vaTomas/PowerTrack/notes/hardware_dictionary.txt

ACS712			Current Sensor

PZEM-004T		Energy Monitor

ZMPT101B		Current and Voltage Transformer
ZMCT103C		Current and Voltage Transformer

SSR-10DA		Power Switch (Prefered)
SRD-05VDC-SL-C		Power Switch (not prefered because of noise)

CD405xB			Analog Multiplexer

HLK-PM12		Power Supply
