vaTomas/PowerTrack/notes/list_decoder_3_to_8.txt

3-to-8 Line Decoder List

Bcd to decimal
74x238	driver	active high
74x138		active low

line to line
74x145	driver
74x141	driver
74x45	driver
74x41	driver
74x42
