vaTomas/PowerTrack/notes/pin_maping.txt

Analog (6 Pins)
A0	LCD Display				1
A1	LCD Display				1
A2	LED Bar Height				2
A3	Voltage Sampler				5
A4	Current Sampler				5
A5	

Digital (14 Pins, 12 Pins Usable)
0	TX Reserved
1	RX Reserved
2	Power Unit Write Bit			4
~3	
4	Power Unit Write Enable			6
~5	
~6	
7	Control Unit				6
8	Multiplexer Socket Selector		3
~9	
~10	
~11	
12	Multiplexer Socket Selector		3
13	Multiplexer Socket Selector		3
