vaTomas/PowerTrack/circuits/manufac/65ed6f54/3D_PCB2_2024-03-10_01.png

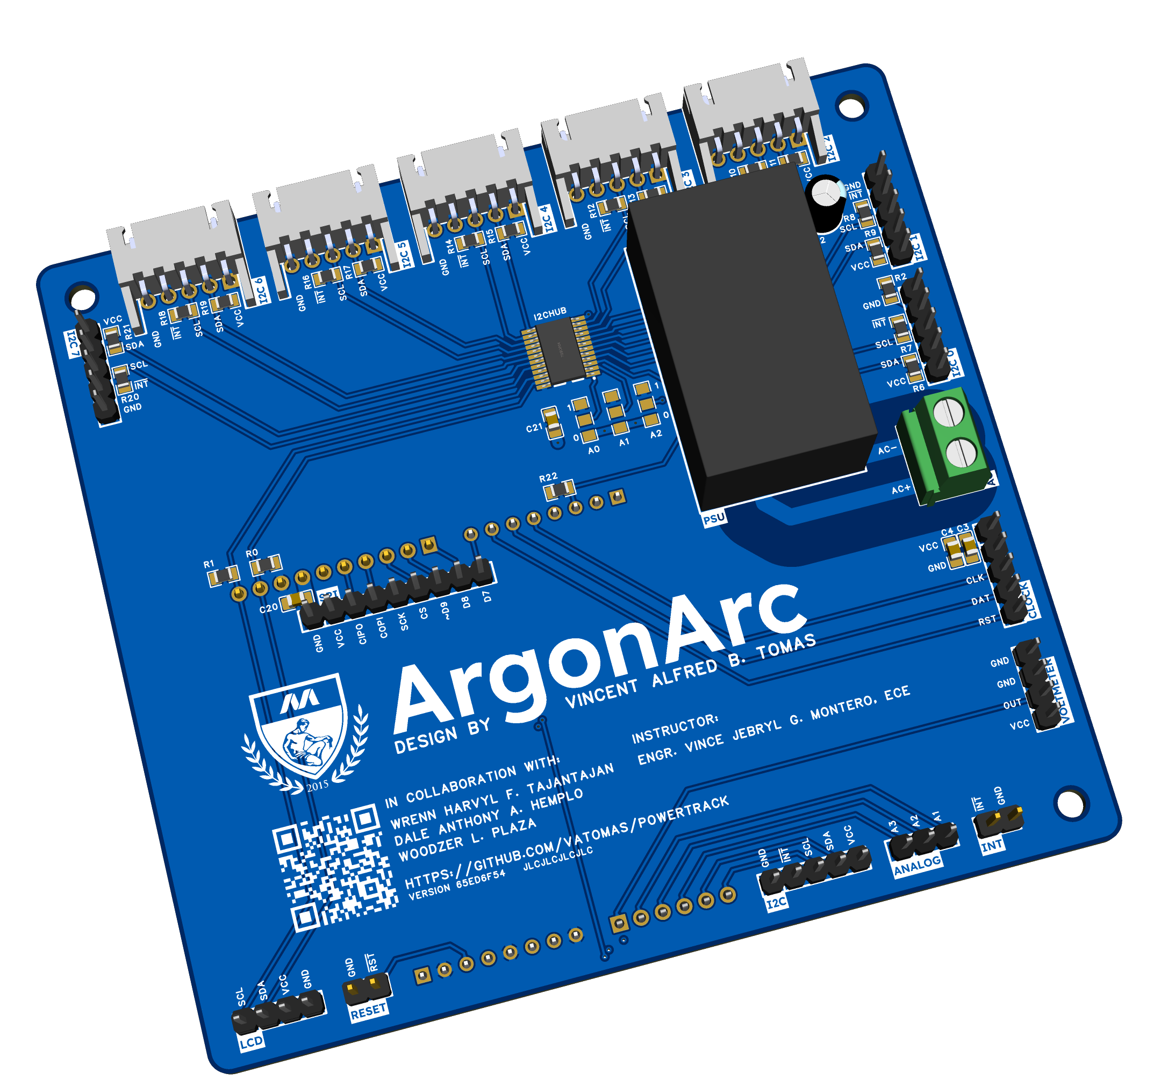
circuits/manufac/65ed6f54/3D_PCB2_2024-03-10_01.png
