vaTomas/PowerTrack/circuits/manufac/65ed8076/3D_PCB7_2024-03-10.png

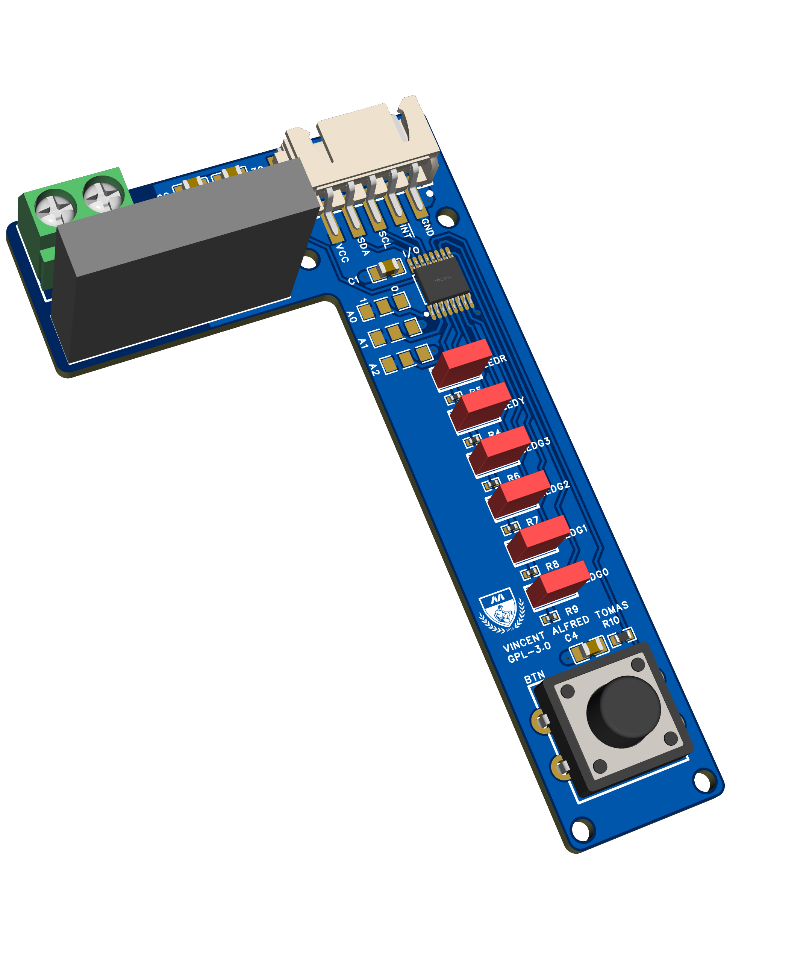
circuits/manufac/65ed8076/3D_PCB7_2024-03-10.png
