vaTomas/PowerTrack/notes/diagrams/block_diagram_electrical_unit.png

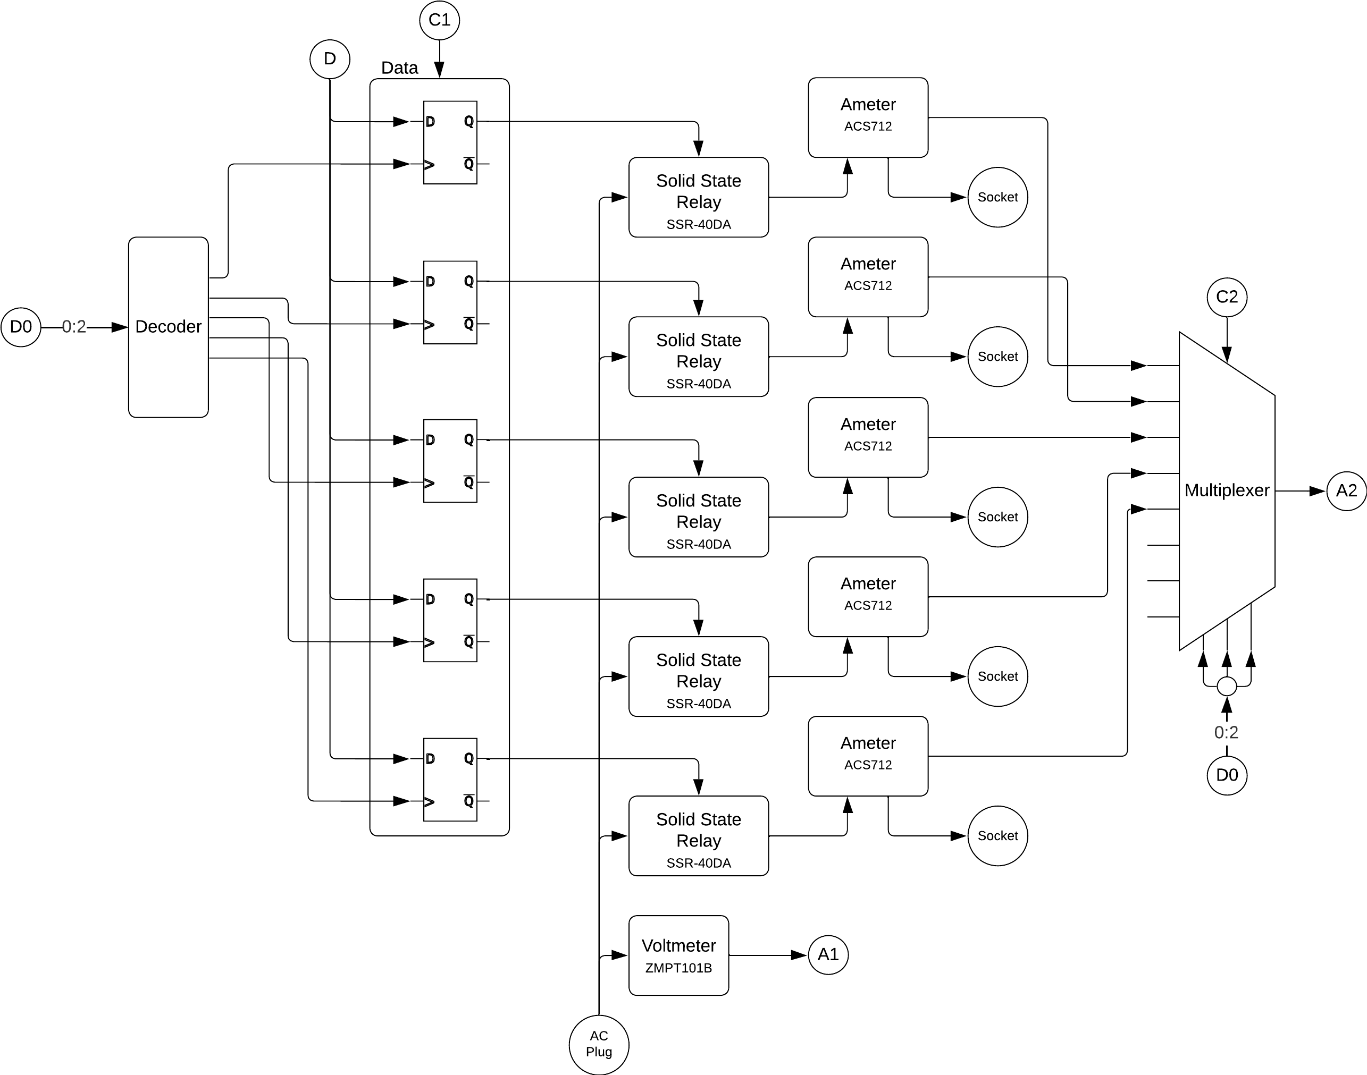
notes/diagrams/block_diagram_electrical_unit.png
