vaTomas/PowerTrack/notes/qr.png

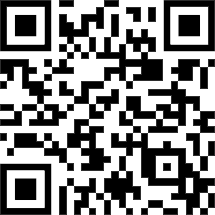
notes/qr.png
