vaTomas/PowerTrack/circuits/manufac/65e47932/BOM_Power Module_PCB7_2024-03-03.csv

No. | Quantity | Comment | Designator | Footprint | Value | Manufacturer Part | Manufacturer | Supplier Part | Supplier
1 | 3 | 0Ω | A0,A1,A2 | R0805 | 0Ω | 0805W8F1002T5E | UNI-ROYAL(厚声) |  | LCSC
2 | 1 | ADS1110A0IDBVR | ADC | SOT-23-6_L2.9-W1.6-P0.95-LS2.8-BR |  | ADS1110A0IDBVR | TI(德州仪器) | C16598 | LCSC
3 | 1 | ACS712ELCTR-05B-T | AMTR | SOIC-8_L5.0-W4.0-P1.27-LS6.0-BL |  | ACS712ELCTR-05B-T | ALLEGRO(美国埃戈罗) | C44471 | LCSC
4 | 1 | TS-1003-10026 | BTN | SW-TH_4P-L12.0-W12.0-P5.00-LS12.5 |  | TS-1003-10026 | XUNPU(讯普) | C455212 | LCSC
5 | 3 | 100nF | C0,C1,C3 | C0805 | 100nF | C2012X7T2E104KT000N | TDK | C342865 | LCSC
6 | 1 | 470nF | C2 | C0805 | 470nF | 0805B474K250CT | FH(风华) |  | LCSC
7 | 1 | 1uF | C4 | C0805 | 1uF | 0805B105K500NT | FH(风华) | C215803 | LCSC
8 | 1 | XH-5PWB | CONN0 | CONN-SMD_5P-P2.50_DEALON_XH-5PWB |  | XH-5PWB | DEALON(德艺隆) | C2905027 | LCSC
9 | 1 | TCA9534APWR | I/O | TSSOP-16_L5.0-W4.4-P0.65-LS6.4-BL |  | TCA9534APWR | TI(德州仪器) | C206010 | LCSC
10 | 4 | Green | LEDG0,LEDG1,LEDG2,LEDG3 | LED-TH_L5.0-W2.7-FD |  | Green | TUOZHAN(拓展光电) | C916071 | LCSC
11 | 1 | Red | LEDR | LED-TH_L5.0-W2.7-FD |  | Red | TOGIALED(统佳) | C440400 | LCSC
12 | 1 | TZ-L2-25FYBY2YCJ150-001 | LEDY | LED-TH_L5.0-W2.7-FD |  | TZ-L2-25FYBY2YCJ150-001 | TUOZHAN(拓展光电) | C916070 | LCSC
13 | 4 | 10kΩ | R0,R1,R2,R10 | R0603 | 10kΩ | 0603WAF1002T5E | UNI-ROYAL(厚声) | C25804 | LCSC
14 | 1 | 2.21kΩ | R4 | R0402 | 2.21kΩ | CR0402FF2211G | LIZ(丽智电子) | C100313 | LCSC
15 | 1 | 3.09kΩ | R5 | R0402 | 3.09kΩ | RTT023091FTH | RALEC(旺诠) | C102967 | LCSC
16 | 4 | 330Ω | R6,R7,R8,R9 | R0402 | 330Ω | 0402WGD3300TCE | UNI-ROYAL(厚声) | C423288 | LCSC
17 | 1 | G3MB-202PL | SSR | RELAY-TH_G3MB-202PL |  | G3MB-202PL | OMRON(欧姆龙) | C48654 | LCSC
18 | 1 | XY126V-5.0-2P | VAC | CONN-TH_XY126V-5.0-2P |  | XY126V-5.0-2P | XINLAIYA(新莱亚) | C557646 | LCSC
