vaTomas/PowerTrack/notes/pcb_layout/PCB_PCB2_2023-11-26.pdf

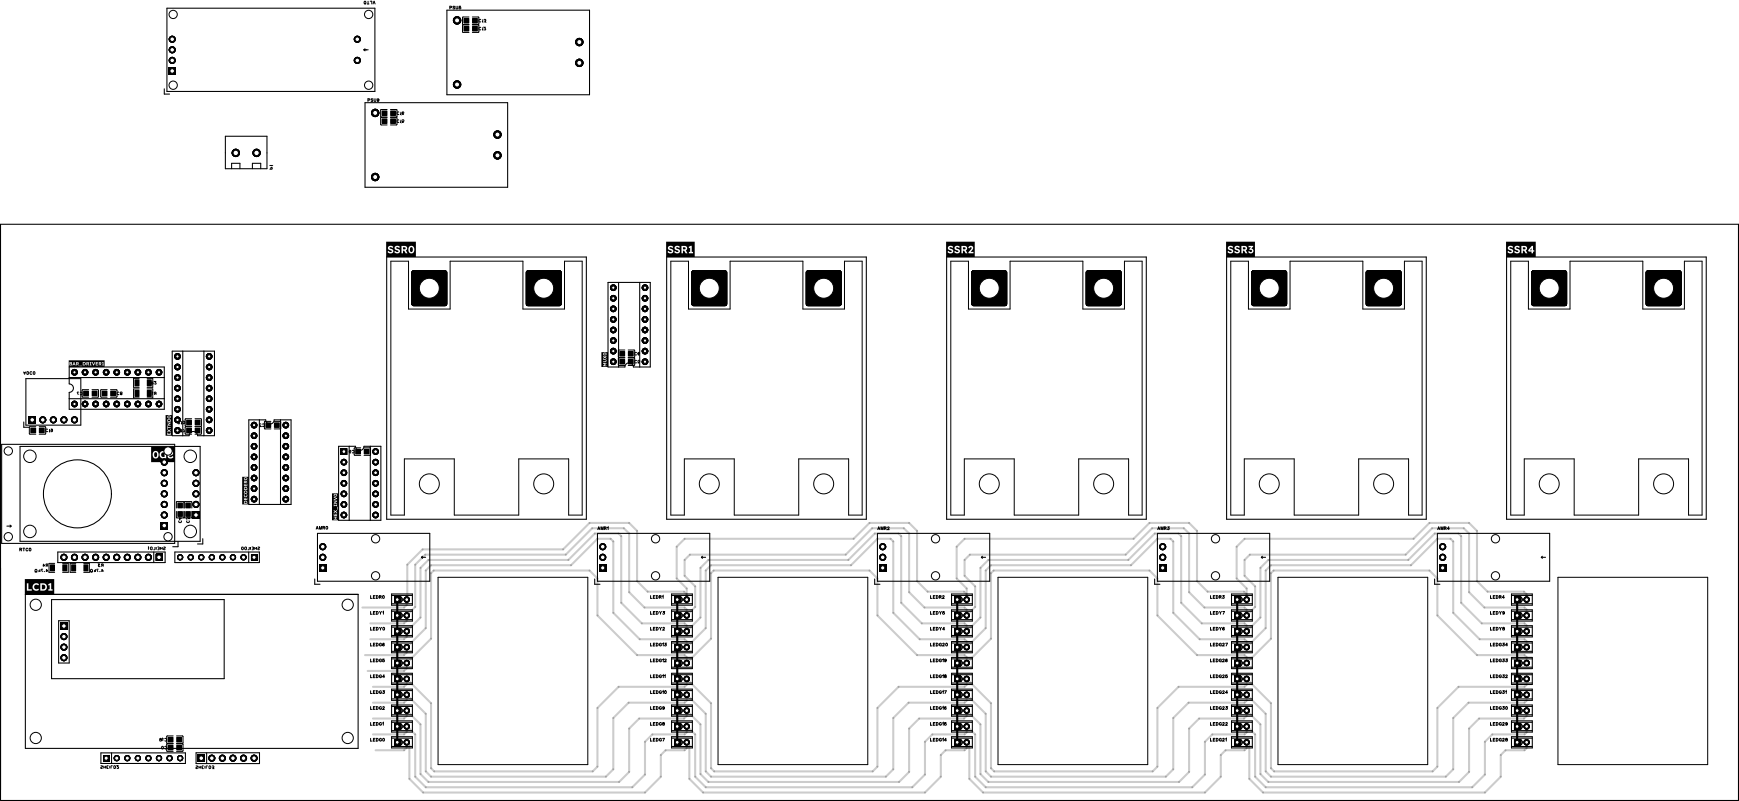
[picture p19: page 1]

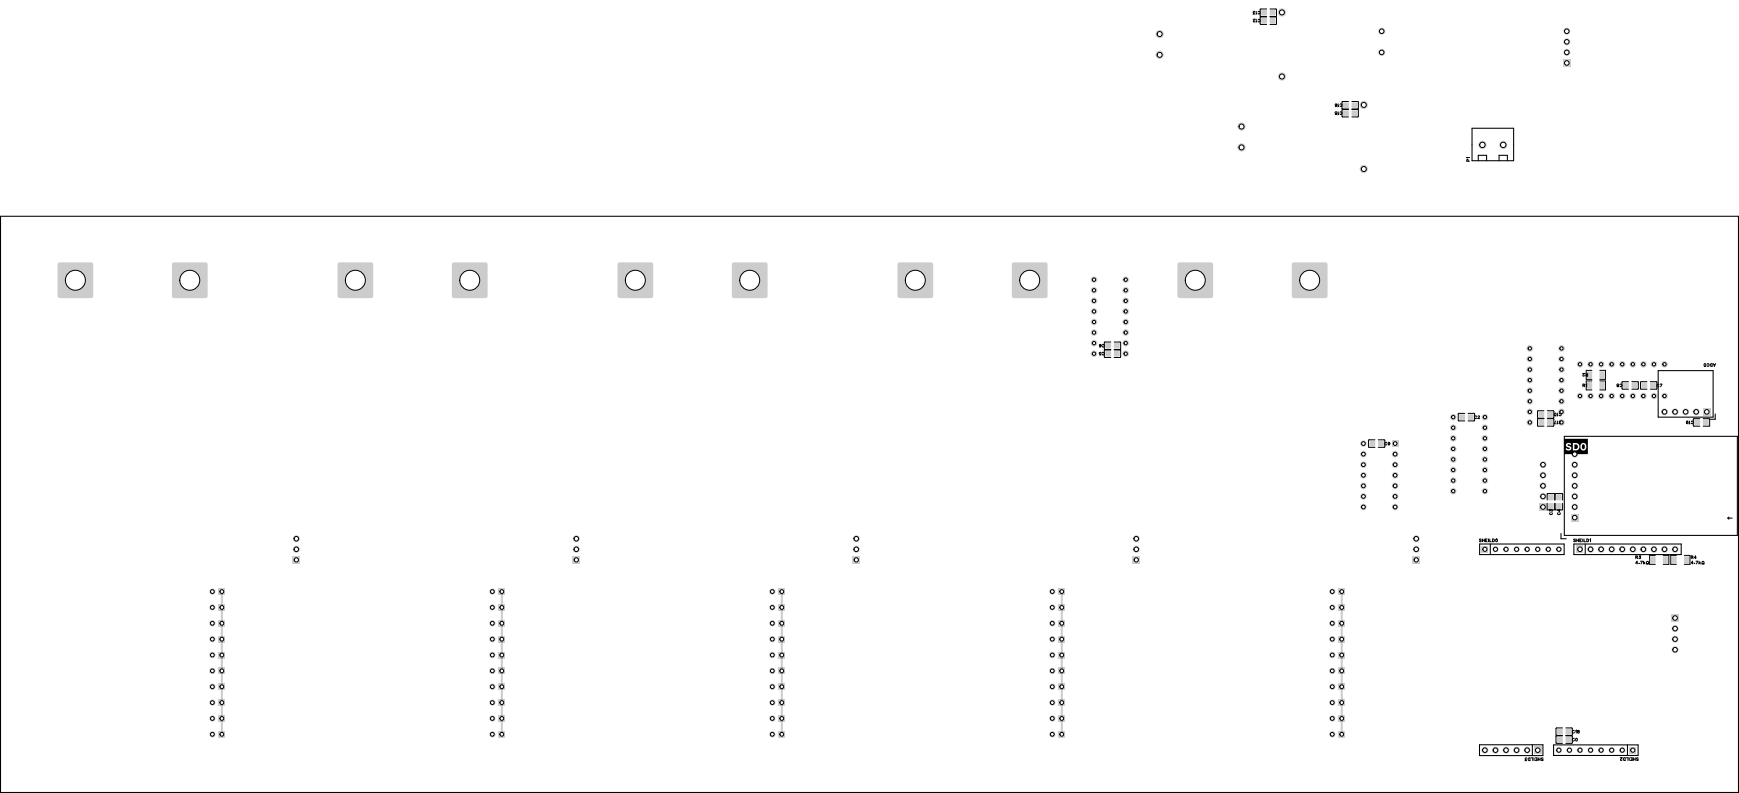
[picture p20: page 2]

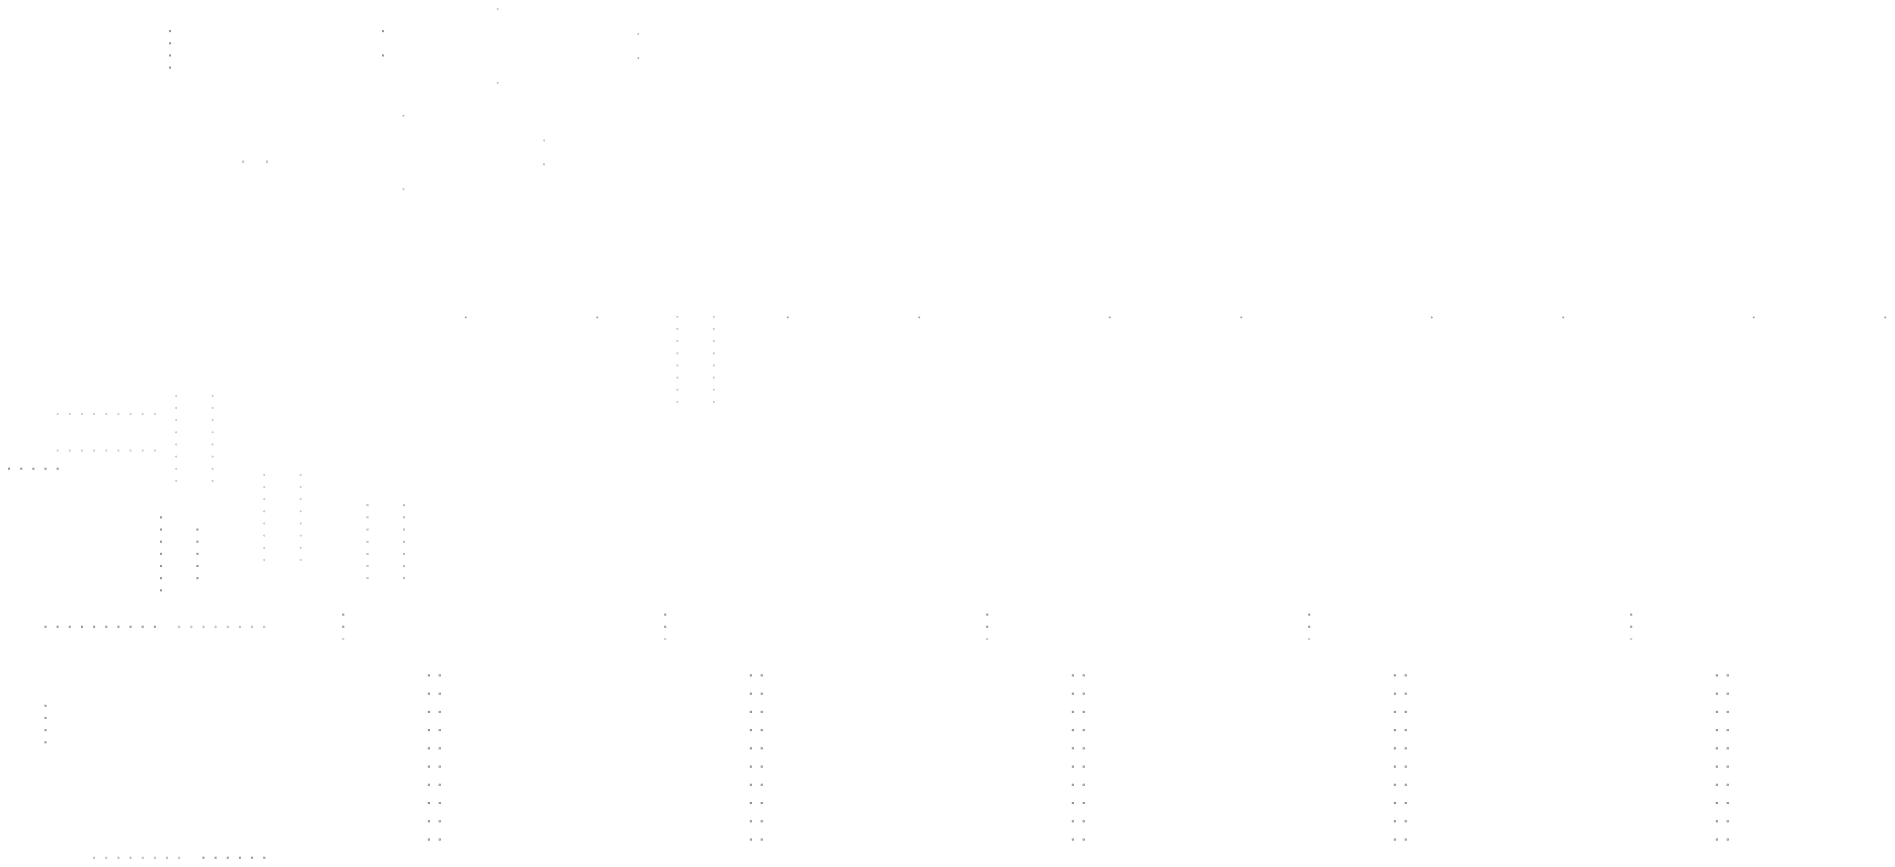
[picture p21: page 3]
