vaTomas/PowerTrack/notes/pcb_layout/PCB_PCB2_2023-11-26_000.pdf

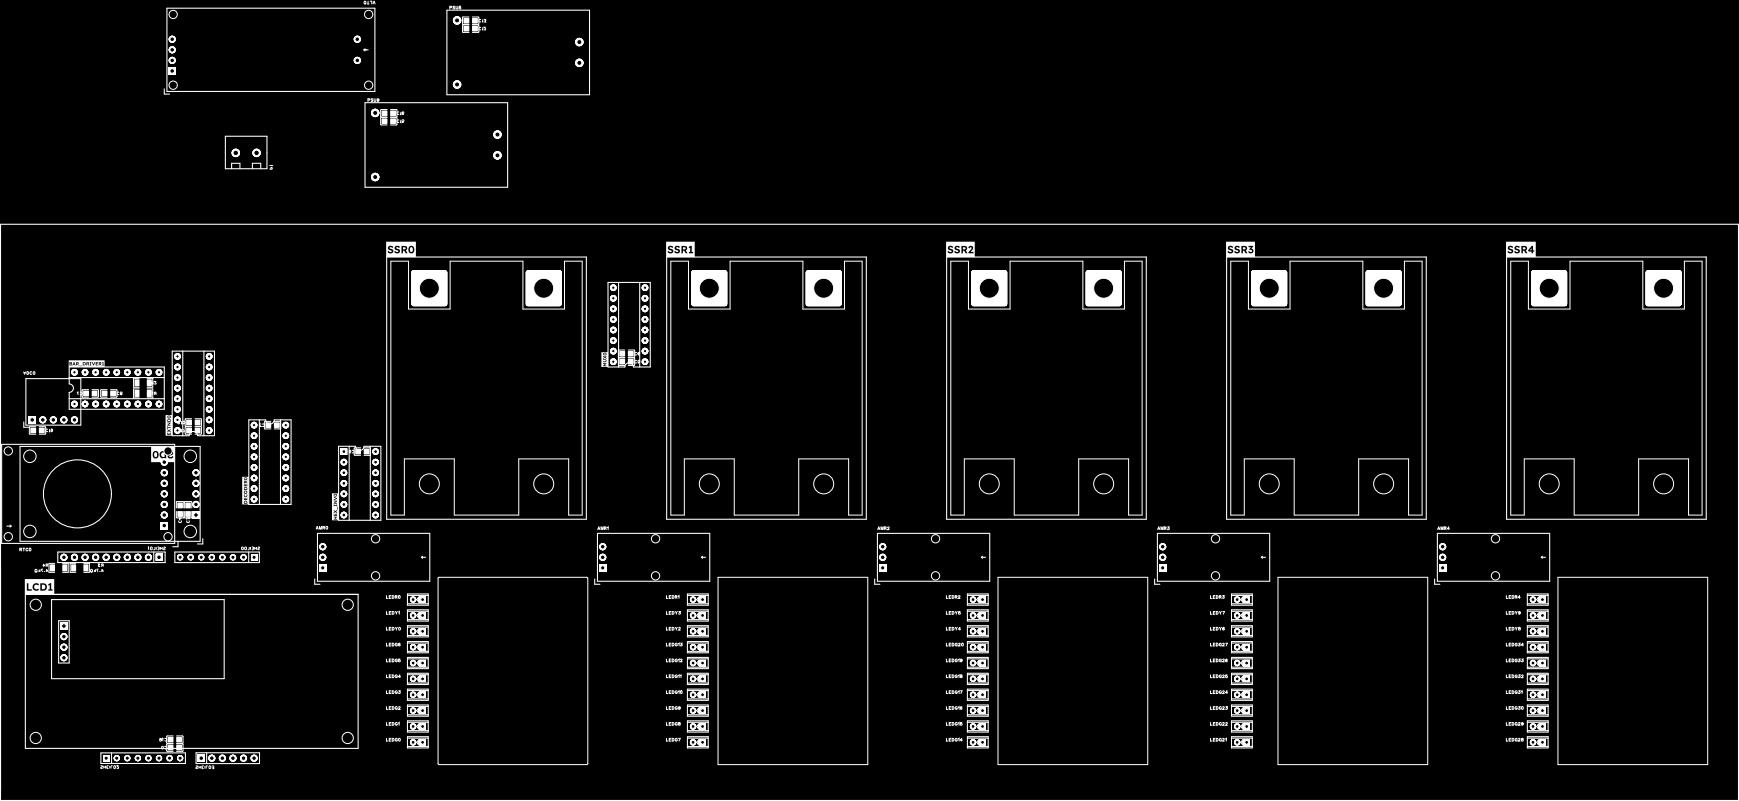
[picture p22: page 1]

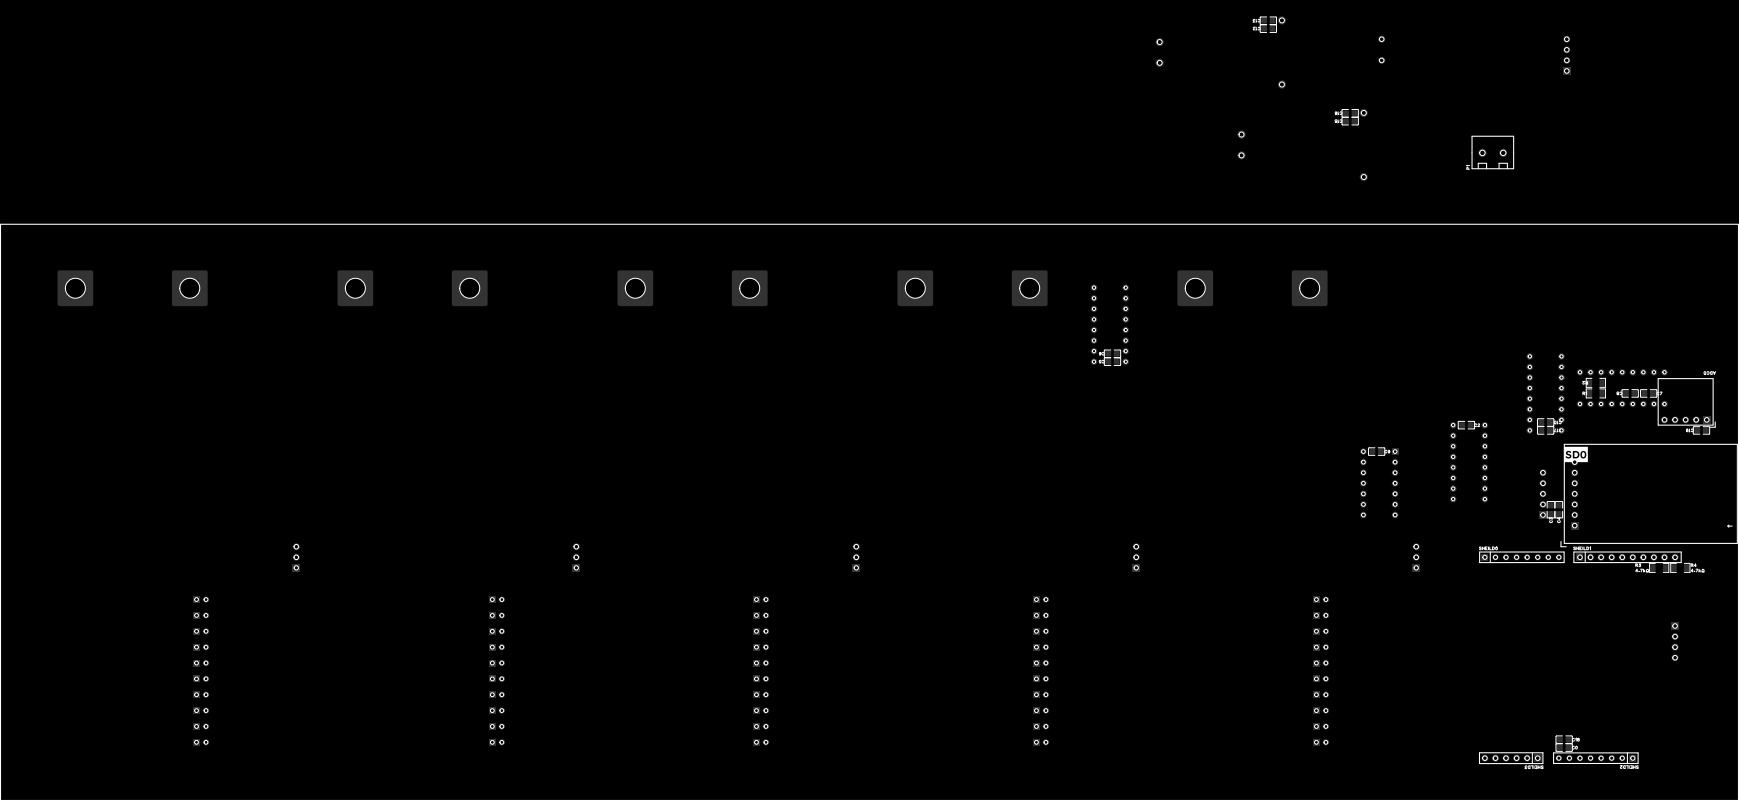
[picture p23: page 2]

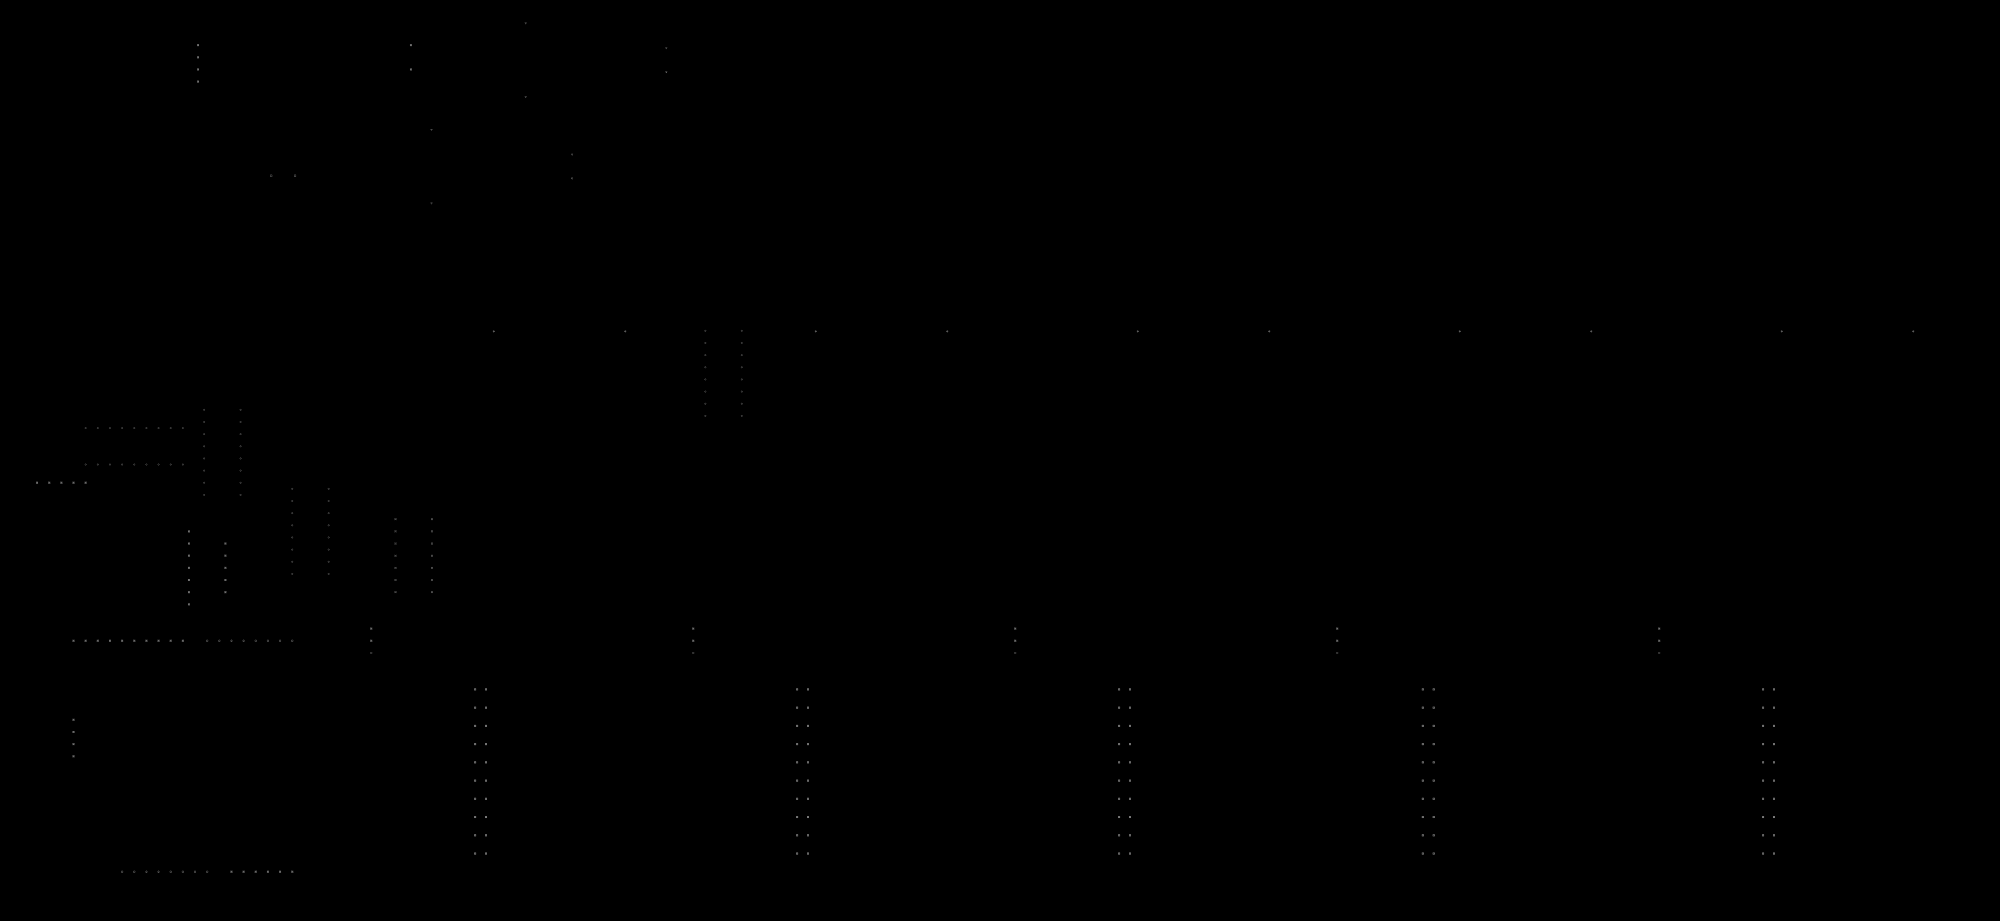
[picture p24: page 3]
