vaTomas/PowerTrack/notes/pcb_layout/PCB_PCB2_2023-12-04_003.pdf

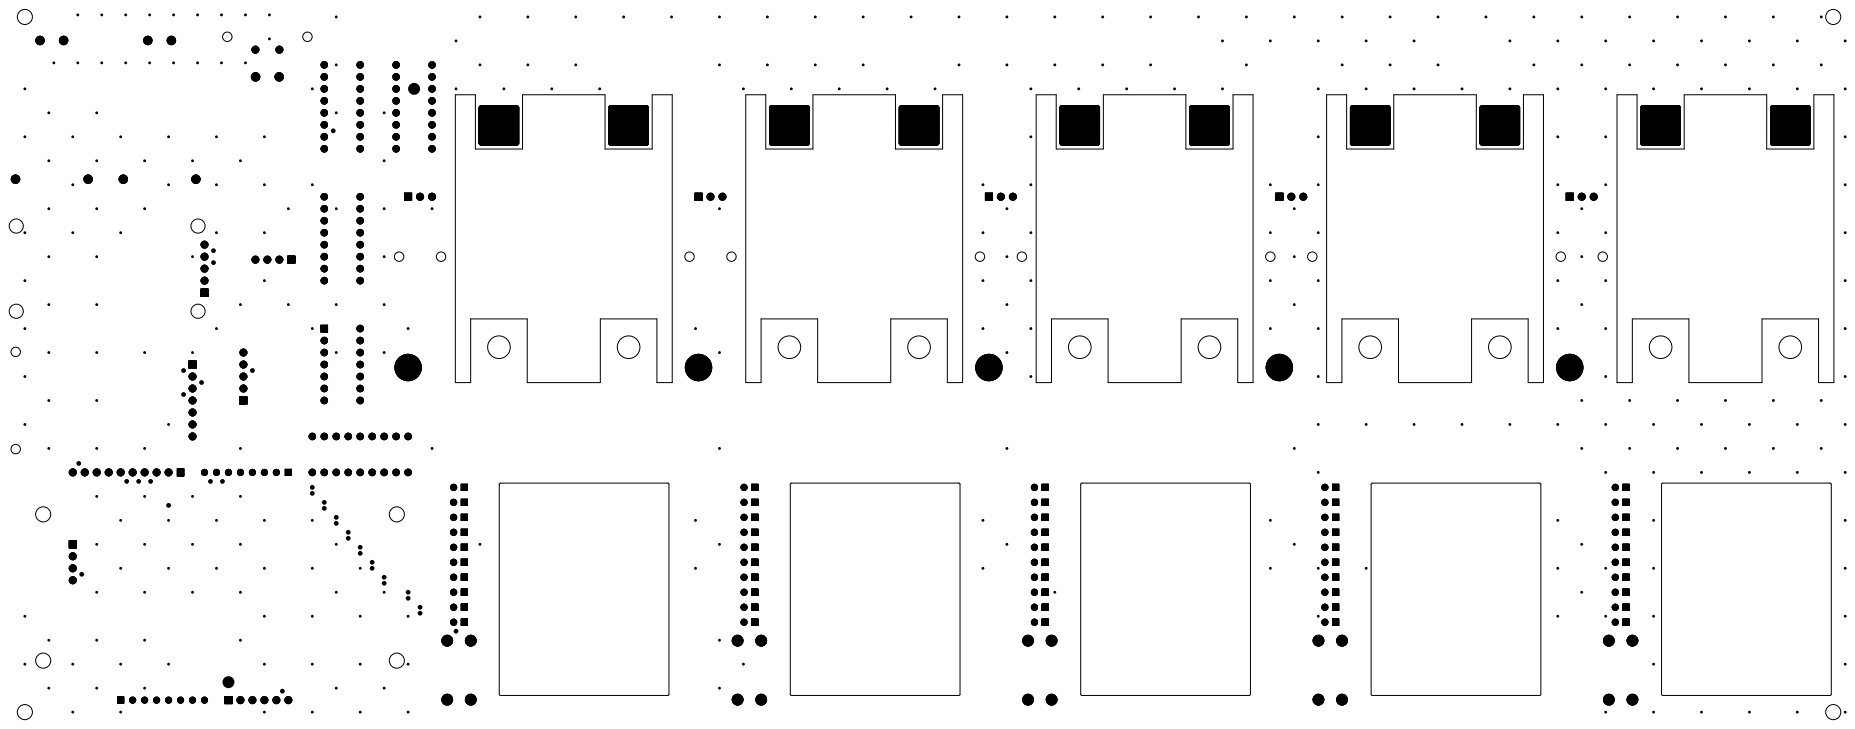
[picture p25: page 1]
