vaTomas/PowerTrack/notes/pcb_layout/PCB_PCB2_2023-12-04_004.pdf

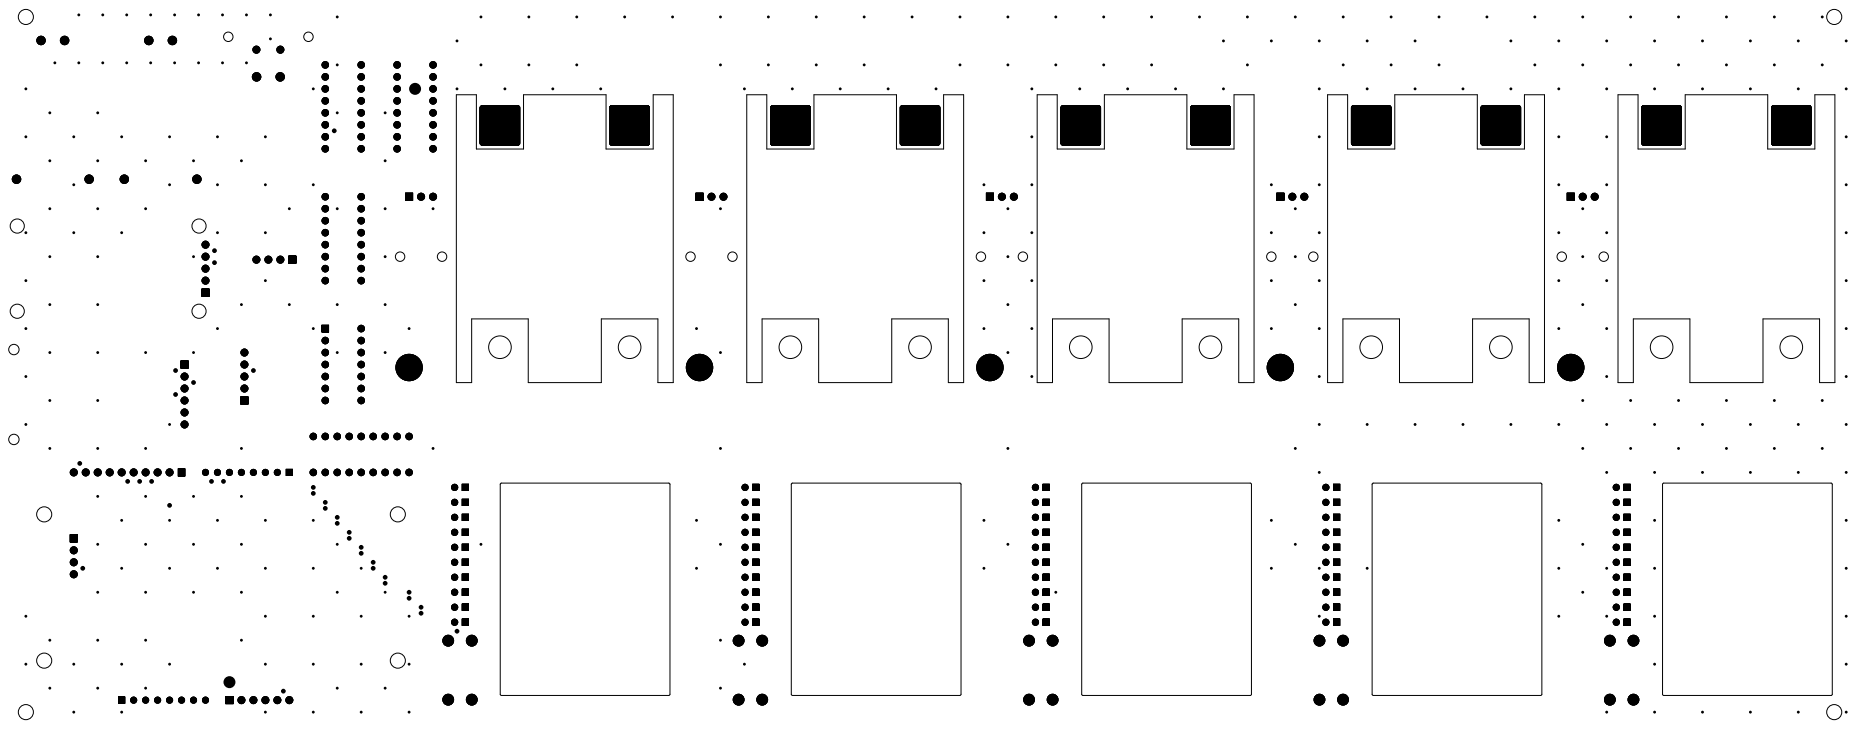
[picture p26: page 1]
