vaTomas/PowerTrack/circuits/manufac/65ed6f54/wireframe_edges.pdf

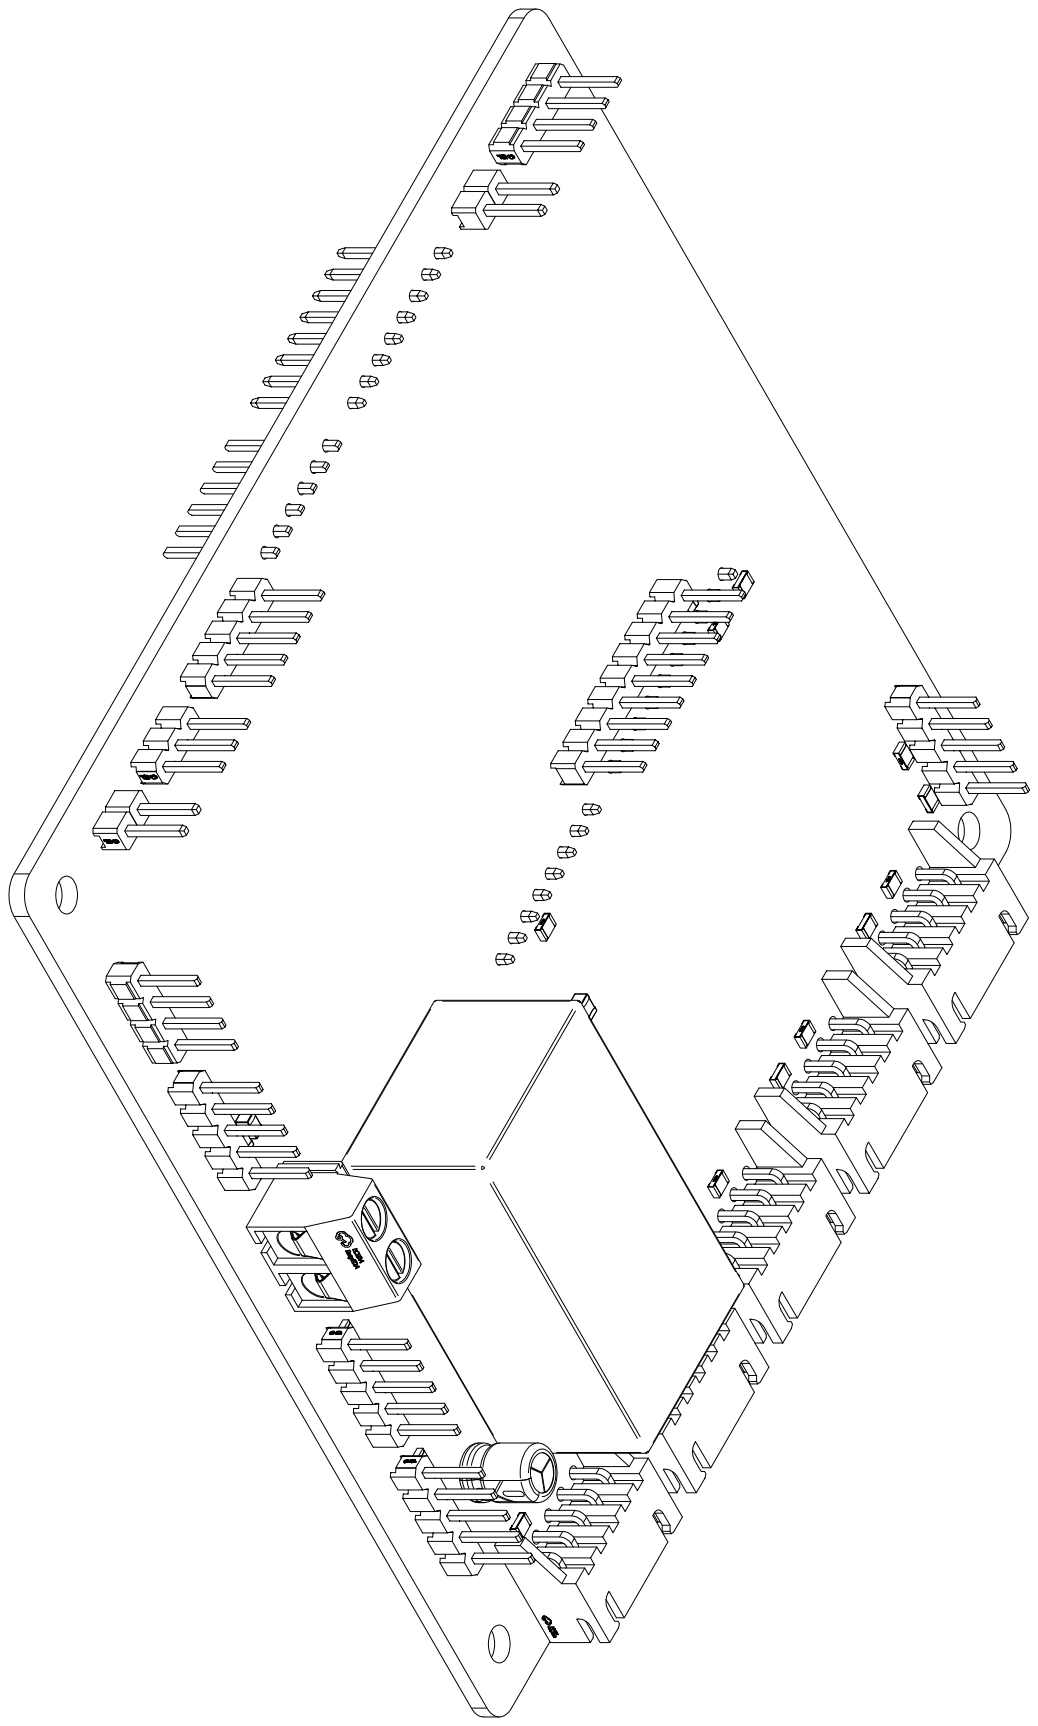
[picture p27: page 1]
