vaTomas/PowerTrack/circuits/manufac/65ed8076/wireframe_edges.pdf

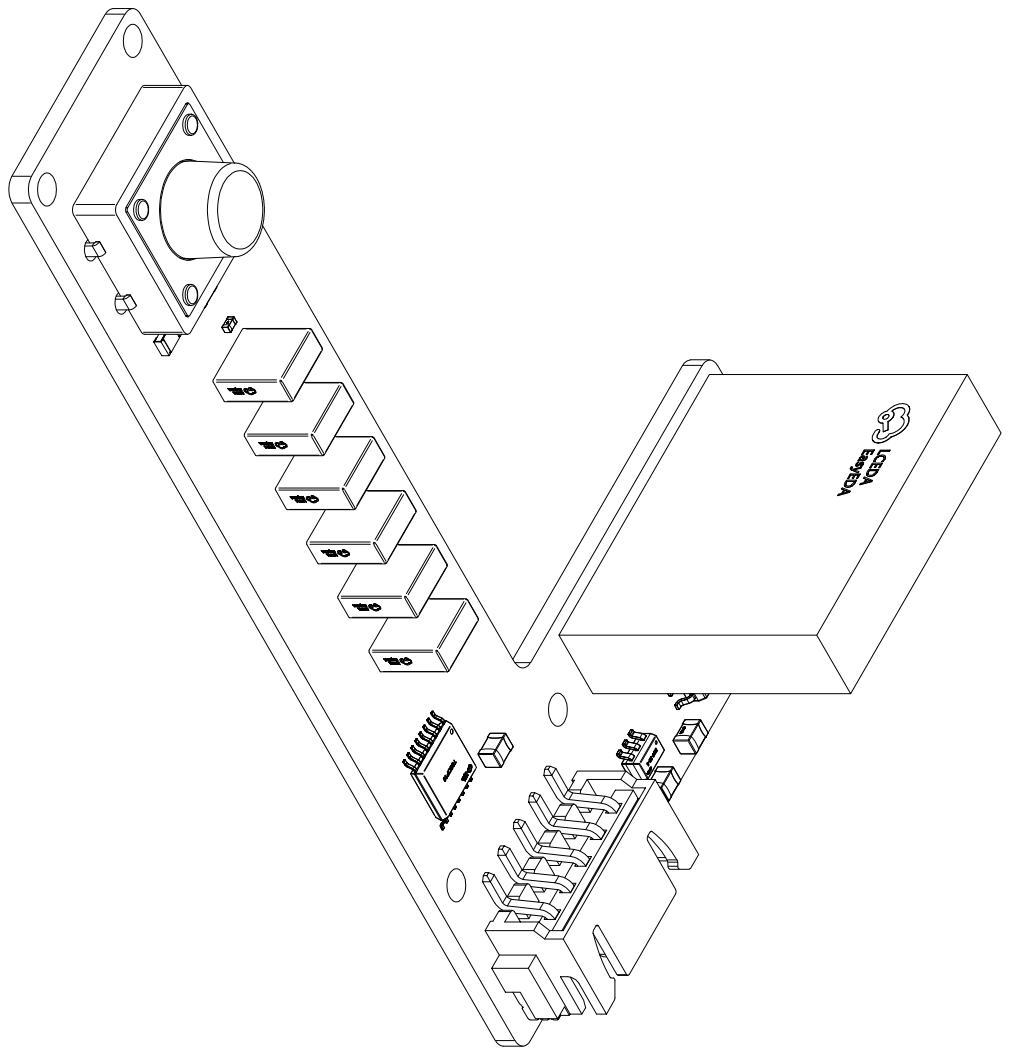
[picture p28: page 1]
