vaTomas/PowerTrack/(list of files, drawings)

Other design files:
circuits/logic_power_switcher.circ
circuits/logic_power_switcher_2.circ
