vaTomas/PowerTrack/(commit log)

2023-10-19 Added more notes to talk about logic and pin allocations
2023-10-19 Added the info and circuit for the power switching
    [logic_power_switcher.circ]
2023-10-25 Created circuits for the power state memory
    [logic_power_switcher_2.circ]
2023-10-30 Furnished socket switcher logic
    [logic_power_switcher_2.circ]
2023-10-30 Did some LM3914 experiments
    [logic_power_switcher_2.circ]
2023-10-31 Experimented with the socket switcher logic
2023-11-03 Did a test for led bar mutliplexing
2023-11-03 Modified socket switcher experiment
2023-11-05 Ameter and Voltmeter testing
2023-11-14 Played with PWM frequency to fix flickering
    [multi_bar.ino]
2024-03-10 Redesigned the entire project
    [BOM_Power Module_PCB7_2024-03-03.csv, BOM_Power Module_PCB7_2024-03-10.csv, PickAndPlace_PCB7_2024-03-03.csv, PickAndPlace_PCB7_2024-03-10.csv, voltage_levels_DAC.xlsx]
2024-03-18 Added latest board files and wrote the documentation
2024-03-20 Started arduino coding. Minimum viable product.
